JpUser1234/Proyecto-2-Diseno-Logico/(commit log)

2026-04-29 Limpieza por encima de las varas
2026-04-30 Definición de CONSTRAINTS
2026-04-30 Cambio modulo TOP, adición de módulos: display_mux, col_scanner, debounce
2026-05-01 ERRORES DE ANTERIOR PROYECTO
    [bcd_to_7seg.sv, top.sv]
2026-05-02 ERROR DE PINES SALIDA ÁNODOS
    [display_mux.sv, top.sv]
2026-05-12 Cambios de Glori, FSM
2026-05-12 Gráficas de osciloscopio
